xjc147896325/gamepad/v2.0/readme.md

V1.0
====
正负极丝印画反 bat的封装不对 过大 下次一定要做防反接

V2.0
=====
生产稿确认超时 部分丝印当时想弄完画直接忘掉 补救的机会也忘了 泪滴忘做 ch340的rx tx画反了 网络就已经反了 电位计封装吃屎 电源正负极丝印没有 没有防反接 啥都没有 oled和sx模块干涉 只能一正一反 can设计不合理 接线端子有伸出去的部分其他没啥了

**10-21**

敲完了adc和按键以及串口debug
非常吃屎 跳线帽的tx rx弄反 关键是原理图的vdda没接3v3直接悬空 我怎么查也没发现，最后在给圣男讲如何吃屎是发现了 跳线过去的 目前还行，vdda没接数据及其失真
遥感买的不咋地 左边x正向及摇杆值中值以下及其吃屎 4096精度 400不能用 单方向1/5没了
