xjc147896325/gamepad/v2.0/demo1.xlsx

Comment | Description | Designator | Footprint | LibRef | Quantity
BAT | Header, 2-Pin | Battery1 | BAT | BAT | 1
10uF | 贴片电容 | C1, C2, C3, C4 | 0603_C | 0603 10uF (106) 10% 10V | 4
20pF | 贴片电容 | C5, C6 | 0603_C | 0603 20pF (200) 5% 50V | 2
100nF | 贴片电容 | C7, C8, C10, C11, C12, C13, C14 | 0603_C | 0603 100nF (104) 10% 50V | 7
22uF | 贴片电容 | C9 | 0603_C | 0603 22uF (226) 20% 6.3V | 1
1uF | 贴片电容 | C15 | 0603_C | 0603 1uF (105) 10% 50V | 1
P923D |  | D1 | RGB_LED_5050 | P923D | 1
红灯 | 发光二极管 | D2 | 0603_LED_S1 | 0603 红灯 | 1
蓝灯 | 发光二极管 | D3 | 0603_LED_S1 | 0603 蓝灯 | 1
BUTTON |  | K1 | BTN8.5*8.5 | BUTTON | 1
摇杆电位计 |  | K2, K4 | 摇杆电位计 | 摇杆电位计 | 2
KEY_M |  | K3, K5, RESET | KEY_M | KEY_M | 3
10uH ±10% | 贴片电感 | L1 | 0603_L | 0603 10uH 10% | 1
SWD | Header, 5-Pin | P1 | HDR1X5 | Header 5 | 1
OLED | Header, 4-Pin | P2 | HDR1X4 | Header 4 | 1
USART | Header, 4-Pin | P3, P4 | HDR1X4 | Header 4 | 2
Header 10 | Header, 10-Pin | P5 | HDR1X10 | Header 10 | 1
NRF24L01 | Header, 4-Pin, Dual row | P6 | HDR2X4 | Header 4X2 | 1
Header 3 | Header, 3-Pin | P7 | HDR1X3 | Header 3 | 1
22Ω | 贴片电阻 | R1, R4 | 0603_R | 0603 22Ω (22R0) 1% | 2
470Ω | 贴片电阻 | R2, R3 | 0603_R | 0603 470Ω (4700) 1% | 2
1.5KΩ | 贴片电阻 | R5 | 0603_R | 0603 1.5KΩ (1501) 1% | 1
10KΩ | 贴片电阻 | R6, R7, R8, R9, R10, R11, R12 | 0603_R | 0603 10KΩ (1002) 1% | 7
STM32F103C8T6 | STM32 ARM-based 32-bit MCU with 64 Kbytes Flash, 48-pin LQFP, Industrial Temperature | U1 | LQFP48_N | STM32F103C8T6 | 1
USB-B(Mini) |  | USB_SLAVE? | USB/SM0.8-6H5 | USB5 | 1
HT7533-1 | 低压差线性稳压(LDO) | VR1 | SOT-89(SOT-89-3) | SOT-89 HT7533-1 | 1
HT7550-1 | 低压差线性稳压(LDO) | VR2 | SOT-89(SOT-89-3) | SOT-89 HT7550-1 | 1
8MHz ±20ppm 20pF | 贴片晶振 | Y1 | SMD-5032_2P | SMD-5032_2P 8MHz 20ppm 20pF | 1
