xjc147896325/gamepad/(list of files, cad)

Other CAD files:
v2.0/模板.dwg
