xjc147896325/gamepad/v2.0/demo2.0.pdf

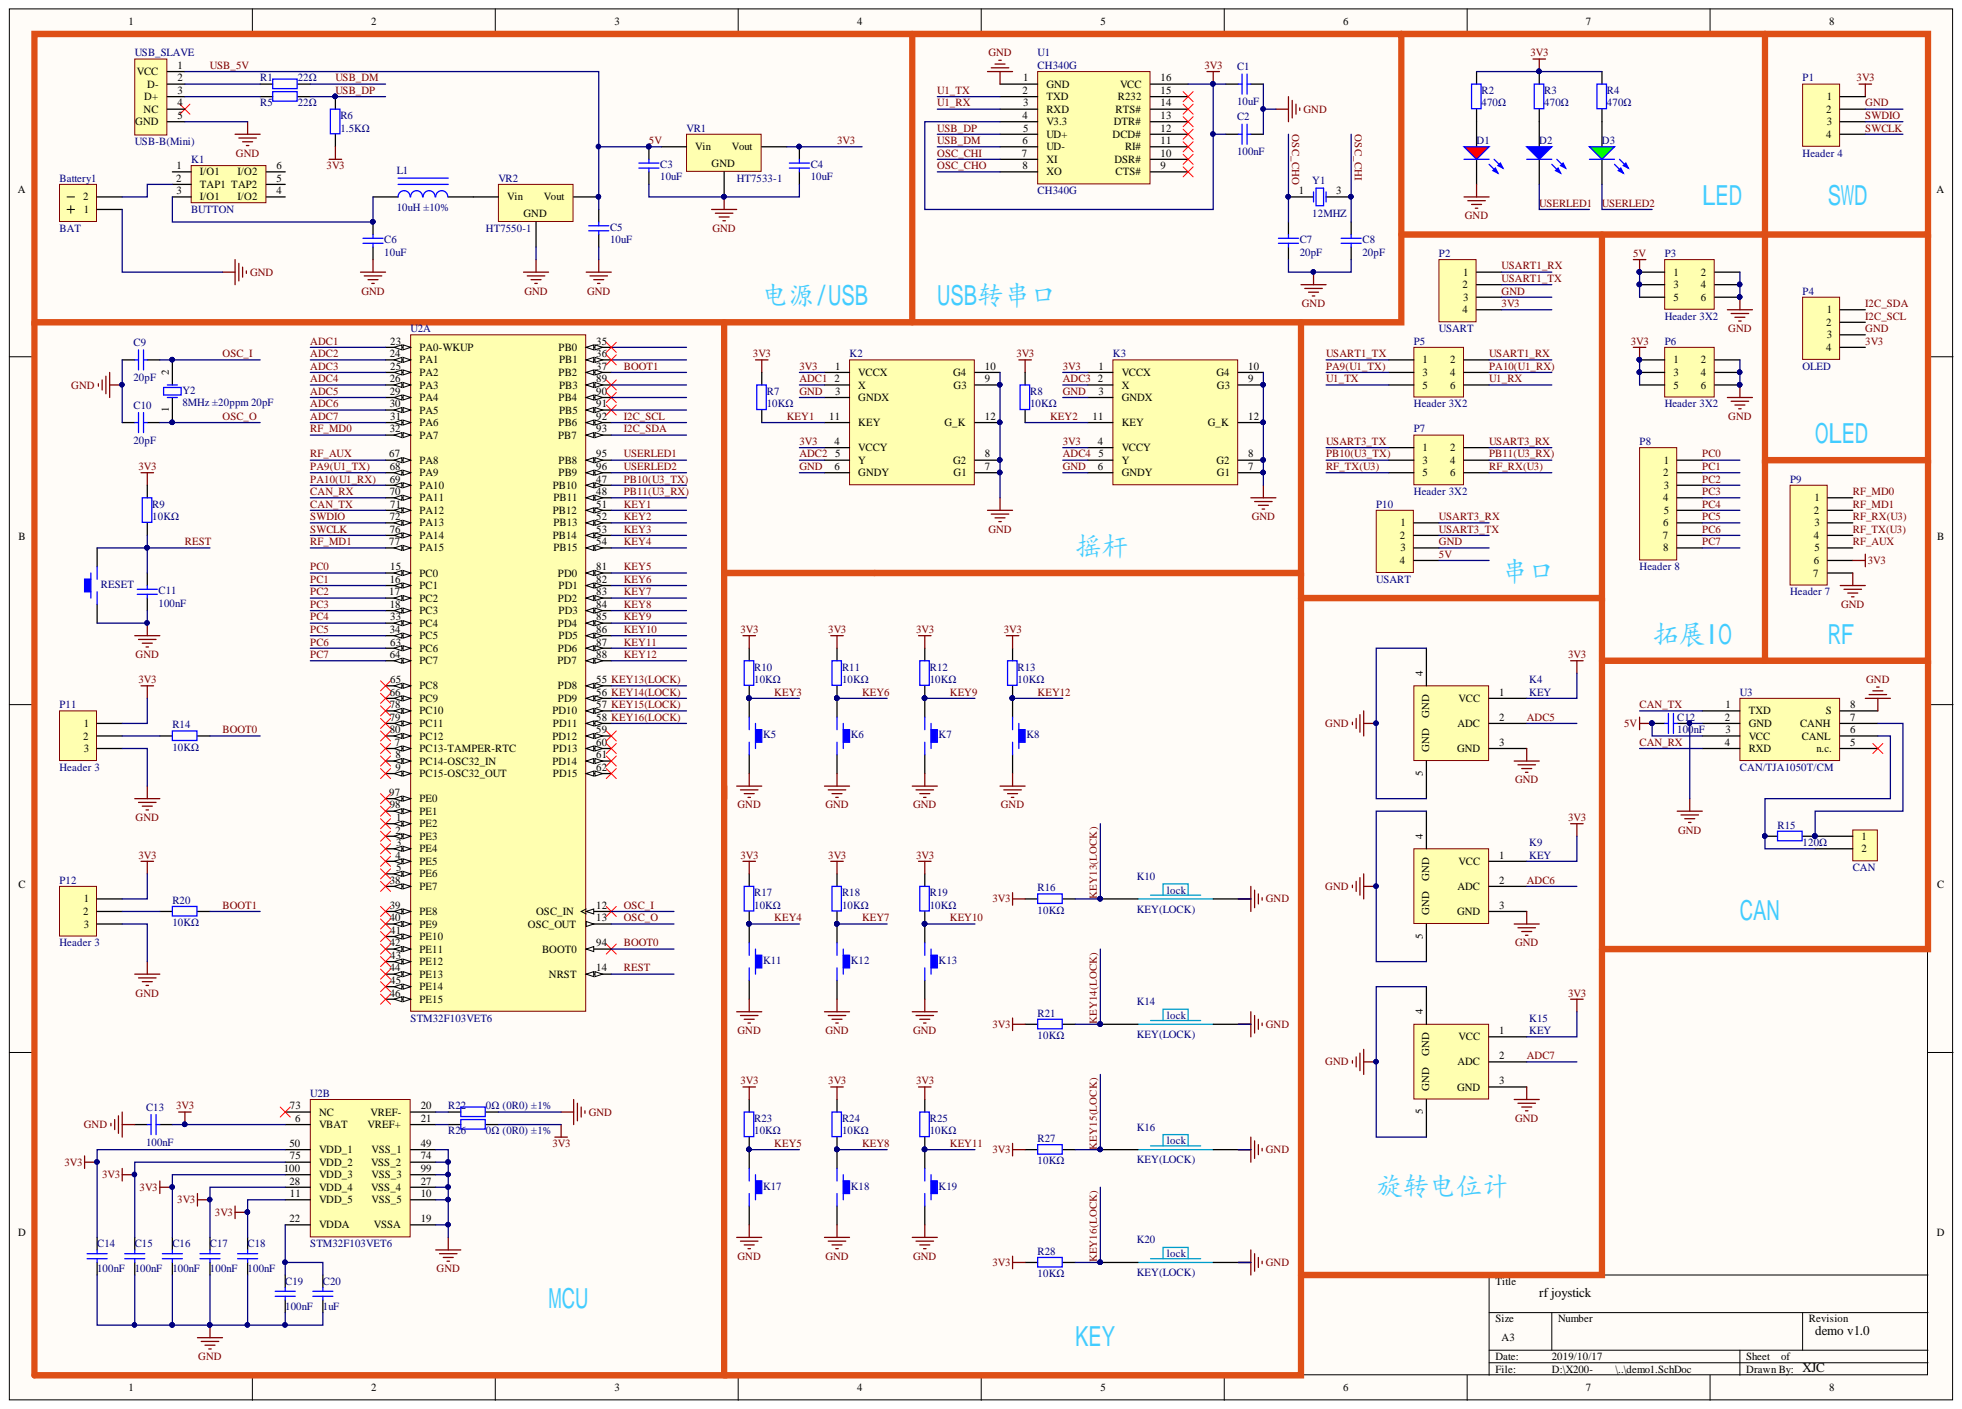
[picture p2: page 1]

VDDA 22
