xjc147896325/gamepad/(list of files, drawings)

Other design files:
v2.0/demo1.PrjPcb
v2.0/demo1.SchDoc
v2.0/摇杆电位计.PcbLib
v2.0/摇杆电位计.SchLib
